Kerol-Dev/Tercio-s1/Github_Files/Images/hero.png

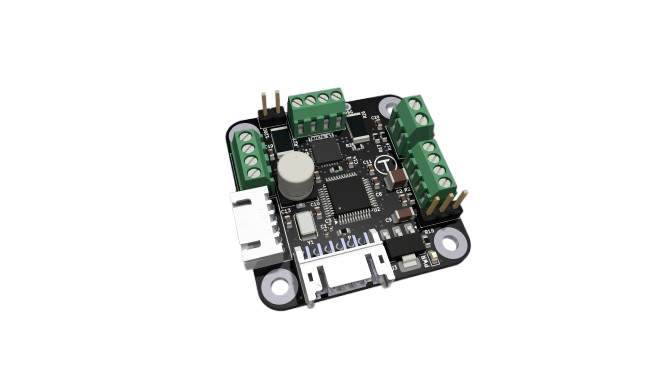
Github_Files/Images/hero.png
