Kerol-Dev/Tercio-s1/Hardware/CAD/NEMA23-Adapter/preview.png

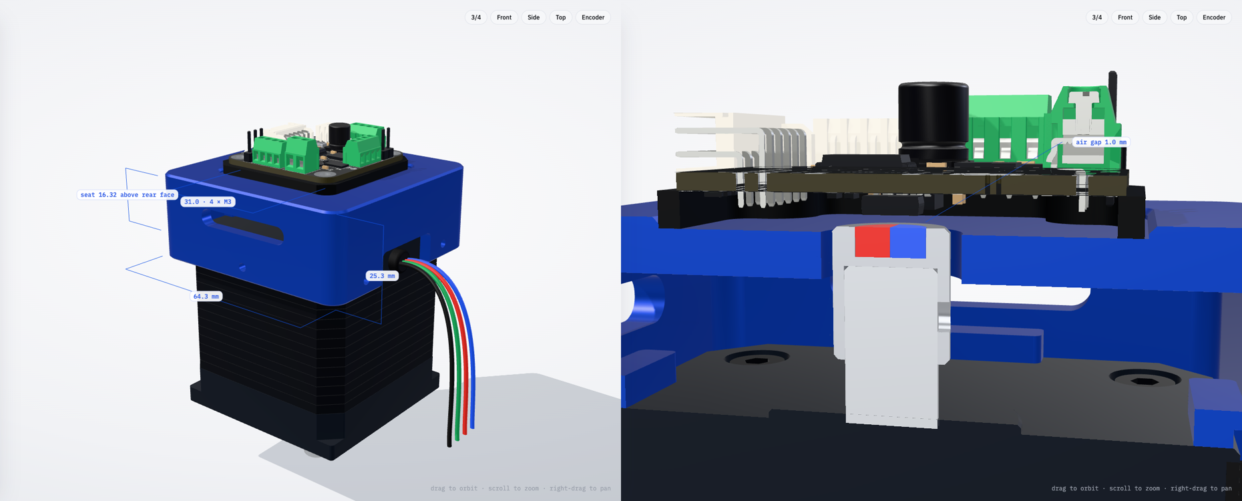
Hardware/CAD/NEMA23-Adapter/preview.png
