Kerol-Dev/Tercio-s1/Hardware/CAD/NEMA23-Adapter/step/Tercio-S1_NEMA23-Assembly.step

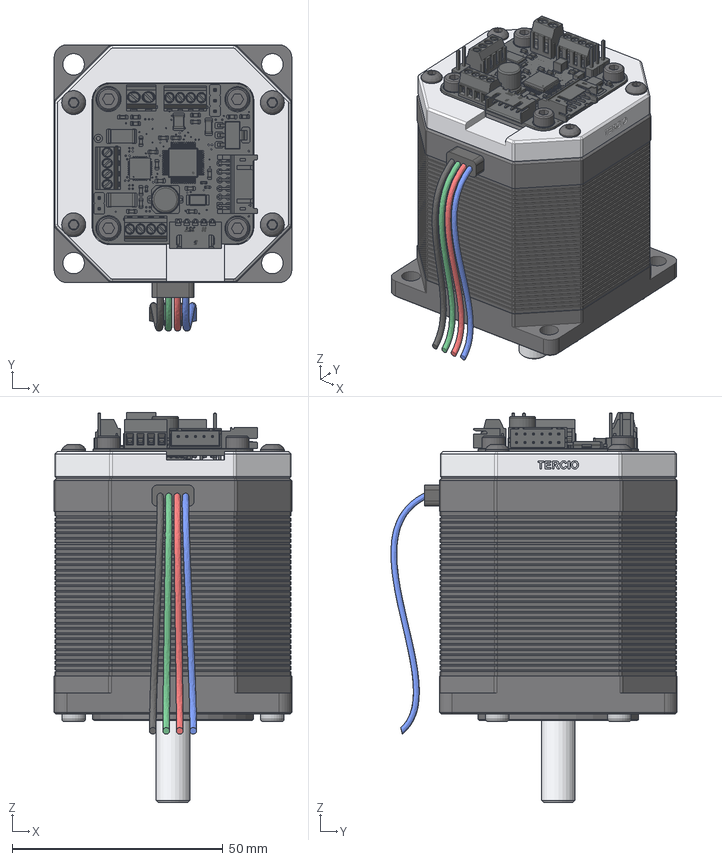
[picture p7: CAD file, 2026-10-11]
Hardware/CAD/NEMA23-Adapter/step/Tercio-S1_NEMA23-Assembly.step
56.4 x 67.9 x 92.5 mm
front_cap
stator
rear_cap
bearing
shaft
pilot
screws
lead_exit
lead_black
lead_green
lead_red
lead_blue
adapter
magnet_n
magnet_s
plate_screws
s1_screws
Tercio_S1
