Kerol-Dev/Tercio-s1/Hardware/CAD/NEMA23-Adapter/step/Tercio-S1_NEMA23-Adapter.step

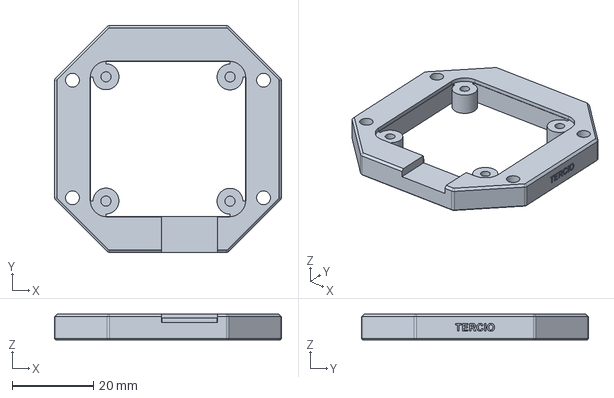
[picture p8: CAD file, 2026-10-11]
Hardware/CAD/NEMA23-Adapter/step/Tercio-S1_NEMA23-Adapter.step
56.0 x 56.0 x 6.34 mm
