Kerol-Dev/Tercio-s1/TercioStepperLib.py

from __future__ import annotations
import struct, threading, time
from dataclasses import dataclass, field
from enum import IntEnum
from typing import Optional, Dict
import serial
from serial.tools import list_ports

# ========= Protocol (MATCHES HTML UI AND FIRMWARE) =========
# TX/RX frame: [ID_LO, ID_HI, CMD, LEN, PAYLOAD...]
HDR_FMT = "<HBB"  # id:uint16, cmd:uint8, len:uint8
HDR_SIZE = struct.calcsize(HDR_FMT)
MAX_PAYLOAD = 64  # guard, fw usually < 64
TELEMETRY_CAN_ID = 0x000
TELEMETRY_CMD = 0x01
GET_CONFIG_CMD = 0x20


class Cmd(IntEnum):
    TARGET_ANGLE = 0x01
    SET_CURRENT_MA = 0x02
    SET_SPEED_LIMIT = 0x03
    SET_PID = 0x04
    SET_ID = 0x05
    SET_MICROSTEPS = 0x06
    SET_STEALTHCHOP = 0x07
    SET_EXT_MODE = 0x08
    SET_UNITS = 0x09  # 0=rad, 1=deg
    SET_ENC_INVERT = 0x0A
    SET_ENABLED = 0x0B
    SET_STEPS_PER_REV = 0x0C
    DO_CALIBRATE = 0x0D
    DO_HOMING = 0x0E
    SET_ENDSTOP = 0x0F
    SET_EXT_ENCODER = 0x10
    SET_ACCEL_LIMIT = 0x11
    SET_DIR_INVERT = 0x12
    SET_EXT_SPI = 0x13
    DO_AUTO_TUNE = 0x14  # New Auto Tune Command
    GET_CONFIG = 0x20


class TuningState(IntEnum):
    IDLE = 0
    PREP = 1
    FWD = 2
    BWD = 3
    INCREASE = 4
    DONE = 5


# ========= Wire formats used in telemetry (same as your FW) =========
AXIS_CONFIG_FMT = "<I H H B B H H f f f f f H"
AXIS_CONFIG_SIZE = struct.calcsize(AXIS_CONFIG_FMT)

# Updated Telemetry Tail:
# float speed, float angle, float target, float temp,
# bool stalled, uint8 tuneState, bool minTrig, bool maxTrig
TELEM_TAIL_FMT = "<f f f f B B B B"
TELEM_TAIL_SIZE = struct.calcsize(TELEM_TAIL_FMT)


@dataclass
class AxisFlags:
    encInvert: bool
    dirInvert: bool
    stealthChop: bool
    externalMode: bool
    enableEndstop: bool
    externalEncoder: bool
    calibratedOnce: bool


@dataclass
class AxisConfig:
    crc32: int
    microsteps: int
    stepsPerRev: int
    units: int
    flags: AxisFlags
    encZeroCounts: int
    driver_mA: int
    maxRPS: float
    maxRPS2: float
    Kp: float
    Ki: float
    Kd: float
    canArbId: int


@dataclass
class AxisState:
    config: AxisConfig
    currentSpeed: float
    currentAngle: float
    targetAngle: float
    temperature: float
    stalled: bool  # New
    tuneState: TuningState  # New
    minTriggered: bool
    maxTriggered: bool
    timestamp: float = field(default_factory=time.time)


@dataclass
class HomingParams:
    useMINTrigger: bool = True
    offset: float = 0.0
    activeLow: bool = True
    speed: float = 1.0
    direction: bool = True  # True => (+)


# ========= pack helpers =========
_u8 = lambda v: struct.pack("<B", v & 0xFF)
_u16 = lambda v: struct.pack("<H", v & 0xFFFF)
_f32 = lambda v: struct.pack("<f", float(v))
_b01 = lambda b: struct.pack("<B", 1 if b else 0)


def _pack_homing(p: HomingParams) -> bytes:
    # <B f B f B> = 11 bytes (exactly what your FW expects)
    return struct.pack(
        "<B f B f B",
        1 if p.useMINTrigger else 0,
        float(p.offset),
        1 if p.activeLow else 0,
        float(p.speed),
        1 if p.direction else 0,
    )


def _make_frame(can_id: int, cmd: int, payload: bytes = b"") -> bytes:
    if not (0 <= can_id <= 0x7FF):
        raise ValueError("can_id must be 11-bit (0..0x7FF)")
    if len(payload) > MAX_PAYLOAD:
        raise ValueError("payload too long")
    return struct.pack(HDR_FMT, can_id, cmd & 0xFF, len(payload)) + payload


# ========= parsing =========
def _parse_axis_config(b: bytes) -> AxisConfig:
    (
        crc32,
        microsteps,
        stepsPerRev,
        units,
        flags_u8,
        encZeroCounts,
        driver_mA,
        maxRPS,
        maxRPS2,
        Kp,
        Ki,
        Kd,
        canArbId,
    ) = struct.unpack(AXIS_CONFIG_FMT, b[:AXIS_CONFIG_SIZE])
    fl = AxisFlags(
        encInvert=bool(flags_u8 & 0x01),
        dirInvert=bool(flags_u8 & 0x02),
        stealthChop=bool(flags_u8 & 0x04),
        externalMode=bool(flags_u8 & 0x08),
        enableEndstop=bool(flags_u8 & 0x10),
        externalEncoder=bool(flags_u8 & 0x20),
        calibratedOnce=bool(flags_u8 & 0x40),
    )
    return AxisConfig(
        crc32,
        microsteps,
        stepsPerRev,
        units,
        fl,
        encZeroCounts,
        driver_mA,
        maxRPS,
        maxRPS2,
        Kp,
        Ki,
        Kd,
        canArbId,
    )


def _parse_telemetry(payload: bytes) -> Optional[AxisState]:
    if len(payload) < AXIS_CONFIG_SIZE + TELEM_TAIL_SIZE:
        return None

    cfg = _parse_axis_config(payload[:AXIS_CONFIG_SIZE])

    # Unpack updated tail (8 items)
    (curSpd, curAng, tgtAng, temp, stalled_u8, tuneState_u8, minT_u8, maxT_u8) = (
        struct.unpack(
            TELEM_TAIL_FMT,
            payload[AXIS_CONFIG_SIZE : AXIS_CONFIG_SIZE + TELEM_TAIL_SIZE],
        )
    )

    return AxisState(
        config=cfg,
        currentSpeed=curSpd,
        currentAngle=curAng,
        targetAngle=tgtAng,
        temperature=temp,
        stalled=bool(stalled_u8),
        tuneState=TuningState(tuneState_u8) if tuneState_u8 <= 5 else TuningState.IDLE,
        minTriggered=bool(minT_u8),
        maxTriggered=bool(maxT_u8),
    )


# ========= Bridge =========
class Bridge:
    def __init__(self, port: Optional[str] = None, baud=115200, timeout=0.05):
        self.port = port
        self.baud = baud
        self.timeout = timeout
        self._ser: Optional[serial.Serial] = None
        self._rx_buf = bytearray()
        self._stop = threading.Event()
        self._reader: Optional[threading.Thread] = None
        self._state: Dict[int, AxisState] = {}
        self._lock = threading.Lock()

    @staticmethod
    def find_first_port() -> str:
        ports = list(list_ports.comports())
        if not ports:
            raise RuntimeError("No serial ports found.")
        return ports[0].device

    def open(self):
        if not self.port:
            self.port = self.find_first_port()
        self._ser = serial.Serial(self.port, self.baud, timeout=self.timeout)
        self._stop.clear()
        self._reader = threading.Thread(target=self._reader_loop, daemon=True)
        self._reader.start()

    def close(self):
        self._stop.set()
        if self._reader and self._reader.is_alive():
            self._reader.join(timeout=1.5)
        if self._ser:
            try:
                self._ser.close()
            except:
                pass
        self._reader = None
        self._ser = None

    # ---- writer
    def send(self, can_id: int, cmd: IntEnum | int, payload: bytes = b""):
        if self._ser is None:
            raise RuntimeError("Bridge not open")
        frame = _make_frame(can_id, int(cmd), payload)
        self._ser.write(frame)
        self._ser.flush()

    # ---- reader
    def _reader_loop(self):
        ser = self._ser
        if not ser:
            return
        try:
            while not self._stop.is_set():
                chunk = ser.read(256)
                if not chunk:
                    continue
                self._rx_buf.extend(chunk)
                self._process_buf()
        except Exception:
            return

    def _process_buf(self):
        while True:
            if len(self._rx_buf) < HDR_SIZE:
                return
            can_id, cmd, ln = struct.unpack(HDR_FMT, self._rx_buf[:HDR_SIZE])
            total = HDR_SIZE + ln
            if len(self._rx_buf) < total:
                return
            payload = bytes(self._rx_buf[HDR_SIZE:total])
            del self._rx_buf[:total]

            # telemetry/config broadcasts
            if can_id == TELEMETRY_CAN_ID and cmd == TELEMETRY_CMD:
                pkt = _parse_telemetry(payload)
                if pkt:
                    with self._lock:
                        self._state[pkt.config.canArbId] = pkt
            elif can_id == TELEMETRY_CAN_ID and cmd == GET_CONFIG_CMD:
                if len(payload) >= AXIS_CONFIG_SIZE:
                    cfg = _parse_axis_config(payload[:AXIS_CONFIG_SIZE])
                    with self._lock:
                        st = self._state.get(cfg.canArbId)
                        if st:
                            st.config = cfg
                        else:
                            # seed with minimal state
                            self._state[cfg.canArbId] = AxisState(
                                config=cfg,
                                currentSpeed=0.0,
                                currentAngle=0.0,
                                targetAngle=0.0,
                                temperature=0.0,
                                stalled=False,
                                tuneState=TuningState.IDLE,
                                minTriggered=False,
                                maxTriggered=False,
                            )

    # ---- state getters
    def get_state(self, can_id: int) -> Optional[AxisState]:
        with self._lock:
            return self._state.get(can_id)

    def request_config(self, can_id: int):
        self.send(can_id, Cmd.GET_CONFIG, b"")

    # ---- high-level command wrappers (id must be provided)
    def set_target_angle(self, can_id: int, angle: float):
        self.send(can_id, Cmd.TARGET_ANGLE, _f32(angle))

    def set_current_ma(self, can_id: int, ma: int):
        self.send(can_id, Cmd.SET_CURRENT_MA, _u16(ma))

    def set_speed_limit_rps(self, can_id: int, rps: float):
        self.send(can_id, Cmd.SET_SPEED_LIMIT, _f32(rps))

    def set_accel_limit_rps2(self, can_id: int, rps2: float):
        self.send(can_id, Cmd.SET_ACCEL_LIMIT, _f32(rps2))

    def set_pid(self, can_id: int, kp: float, ki: float, kd: float):
        self.send(can_id, Cmd.SET_PID, _f32(kp) + _f32(ki) + _f32(kd))

    def set_can_id(self, can_id: int, new_id: int):
        self.send(can_id, Cmd.SET_ID, _u16(new_id & 0x7FF))

    def set_microsteps(self, can_id: int, microsteps: int):
        self.send(can_id, Cmd.SET_MICROSTEPS, _u16(microsteps))

    def set_stealthchop(self, can_id: int, enable: bool):
        self.send(can_id, Cmd.SET_STEALTHCHOP, _b01(enable))

    def set_external_mode(self, can_id: int, enable: bool):
        self.send(can_id, Cmd.SET_EXT_MODE, _b01(enable))

    def set_units_degrees(self, can_id: int, use_degrees: bool):
        self.send(can_id, Cmd.SET_UNITS, _u8(1 if use_degrees else 0))

    def set_encoder_invert(self, can_id: int, enable: bool):
        self.send(can_id, Cmd.SET_ENC_INVERT, _b01(enable))

    def set_direction_invert(self, can_id: int, invert: bool):
        self.send(can_id, Cmd.SET_DIR_INVERT, _b01(invert))

    def enable_motor(self, can_id: int, enable: bool):
        self.send(can_id, Cmd.SET_ENABLED, _b01(enable))

    def set_steps_per_rev(self, can_id: int, steps_per_rev: int):
        self.send(can_id, Cmd.SET_STEPS_PER_REV, _u16(steps_per_rev))

    def set_external_encoder(self, can_id: int, enable: bool):
        self.send(can_id, Cmd.SET_EXT_ENCODER, _b01(enable))

    def set_external_spi(self, can_id: int, enable: bool):
        self.send(can_id, Cmd.SET_EXT_SPI, _b01(enable))

    def set_endstop(self, can_id: int, enable: bool):
        self.send(can_id, Cmd.SET_ENDSTOP, _b01(enable))

    def do_calibrate(self, can_id: int):
        self.send(can_id, Cmd.DO_CALIBRATE, b"")

    def do_homing(self, can_id: int, p: HomingParams):
        self.send(can_id, Cmd.DO_HOMING, _pack_homing(p))

    def do_auto_tune(self, can_id: int, min_angle: float, max_angle: float):
        # Sends two floats: min, max (degrees usually, handled by firmware units logic)
        payload = struct.pack("<ff", float(min_angle), float(max_angle))
        self.send(can_id, Cmd.DO_AUTO_TUNE, payload)


# ========= Friendly Stepper wrapper (pins id) =========
class Stepper:
    def __init__(self, bridge: Bridge, can_id: int):
        if not (0 <= can_id <= 0x7FF):
            raise ValueError("11-bit CAN id expected")
        self.bridge = bridge
        self.id = can_id

    # convenience
    def request_config(self):
        self.bridge.request_config(self.id)

    def enable_motor(self, en: bool):
        self.bridge.enable_motor(self.id, en)

    def set_target_angle(self, ang: float):
        self.bridge.set_target_angle(self.id, ang)

    def set_current_ma(self, ma: int):
        self.bridge.set_current_ma(self.id, ma)

    def set_speed_limit_rps(self, rps: float):
        self.bridge.set_speed_limit_rps(self.id, rps)

    def set_accel_limit_rps2(self, rps2: float):
        self.bridge.set_accel_limit_rps2(self.id, rps2)

    def set_pid(self, kp, ki, kd):
        self.bridge.set_pid(self.id, kp, ki, kd)

    def set_can_id(self, new_id: int):
        self.bridge.set_can_id(self.id, new_id)
        self.id = new_id & 0x7FF

    def set_microsteps(self, m: int):
        self.bridge.set_microsteps(self.id, m)

    def set_stealthchop(self, en: bool):
        self.bridge.set_stealthchop(self.id, en)

    def set_external_mode(self, en: bool):
        self.bridge.set_external_mode(self.id, en)

    def set_units_degrees(self, on: bool):
        self.bridge.set_units_degrees(self.id, on)

    def set_encoder_invert(self, on: bool):
        self.bridge.set_encoder_invert(self.id, on)

    def set_direction_invert(self, on: bool):
        self.bridge.set_direction_invert(self.id, on)

    def set_external_encoder(self, on: bool):
        self.bridge.set_external_encoder(self.id, on)

    def set_external_spi(self, on: bool):
        self.bridge.set_external_spi(self.id, on)

    def set_endstop(self, on: bool):
        self.bridge.set_endstop(self.id, on)

    def do_calibrate(self):
        self.bridge.do_calibrate(self.id)

    def do_homing(self, p: HomingParams):
        self.bridge.do_homing(self.id, p)

    def do_auto_tune(self, min_angle: float, max_angle: float):
        """
        Starts the auto-tuning process.
        :param min_angle: Minimum angle for the tuning sweep.
        :param max_angle: Maximum angle for the tuning sweep.
        """
        self.bridge.do_auto_tune(self.id, min_angle, max_angle)

    def get_axis_state(self) -> Optional[AxisState]:
        return self.bridge.get_state(self.id)
