Kerol-Dev/Tercio-s1/(commit log)

2025-11-17 Major fixes, pid fix.
    [main.cpp, test.py]
2025-11-28 Stall and auto tune added.
    [TercioStepperLib.py, main.cpp, test.py]
2026-02-13 Add README for Tercio S1 Stepper Driver
    Added detailed information about the Tercio S1 stepper driver, including features, quick start guide, documentation, support, availability, and licensing.
2026-09-30 Firmware v2, protocol v2 and a new web control panel
    Firmware (rewritten):
    - 20 kHz control loop on TIM7, independent of loop() timing: encoder PLL,
    online trapezoid planner, feed-forward + PI position controller, step
    generation on TIM1 CH2N; Q32.32 fixed-point positions, no double in the ISR
    - Pin map follows the schematic (driver enable on PB5 now works)
    - AS5600 (I2C) and AS5048A (SPI) encoders; calibration, homing and auto-tune
    procedures; wear-levelled flash settings; HSE verified at start-up
    - HAL FDCAN, no third-party libraries; platform pinned to ststm32@20.0.0
    - Host tests: pio test -e native
    CAN protocol v2: command/reply/telemetry/event ID ranges, [cmd][status]
    replies, pa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
    [Analog.cpp, Analog.h, As5048a.cpp, As5048a.h, As5600.cpp, As5600.h, Axis.cpp, Axis.h]
2026-09-30 Tercio Control: URL options for embeds, two-state theme toggle
    The panel can be opened as ?demo (starts the demo bus) and ?theme=light|dark
    (this visit only), so the website can embed it. The theme button now flips
    between light and dark from whatever is in effect instead of cycling through
    "match system". Also hides the pioarduino extension recommendation.
    [Settings.h]
2026-09-30 Rewrite the README; keep the product film out of git
    The README now matches the product as built: 12-bit AS5600 (4,096 counts),
    20 kHz position loop, TMC2209 up to 1.77 A RMS per coil, 12-28 V, 38 x 38 mm,
    CAN FD 500 kbit/s / 2.5 Mbit/s with up to 127 nodes, and the December 1, 2026
    launch. It adds how the loop works, the S1 + FD system, specifications, quick
    start, the Python and Arduino libraries, firmware build and test commands,
    the CAN ID map, and the repository layout, with new renders and a Tercio
    Control screenshot. Links point at the live workers.dev / pages.dev sites.
    .gitignore: Marketing/demo-video (renders, audio, node_modules), video files,
    .DS_Store, and the local .claude con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
2026-10-11 Add the NEMA 23 adapter: CAD source, STEP files and a 3D viewer
    A compact cap that bolts to a NEMA 23's rear screw holes and carries the
    Tercio S1 over the shaft magnet. adapter.py builds the model; step/ holds
    the adapter and the full assembly; viewer/ shows them in the browser.
2026-10-11 Support the Tercio IMU on protocol v2
    The IMU's firmware 2 (Kerol-Dev/Tercio-imu) joins protocol v2, so the
    tools now treat it as a node like the S1.
    - Protocol: GetInfo gains a trailing device-class byte (0 S1, 1 IMU);
    a 20-byte reply still reads as an S1. Frame type 0x03 is reserved for
    IMU telemetry.
    - Tercio Control: a new IMU page with an artificial horizon and compass,
    a roll/pitch/yaw chart, calibration meters and Save calibration, Zero
    and Zero heading, settings and diagnostics. IMUs appear under Sensors
    and on the overview; the demo bus has one.
    - Python and Arduino libraries: an Imu class for telemetry, zeroing,
    calibration and parameters; discovery reports the device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
